leandro931/PIC-Data-Logger/gerber/Rev0a/data_logger_Rev0a.jpg

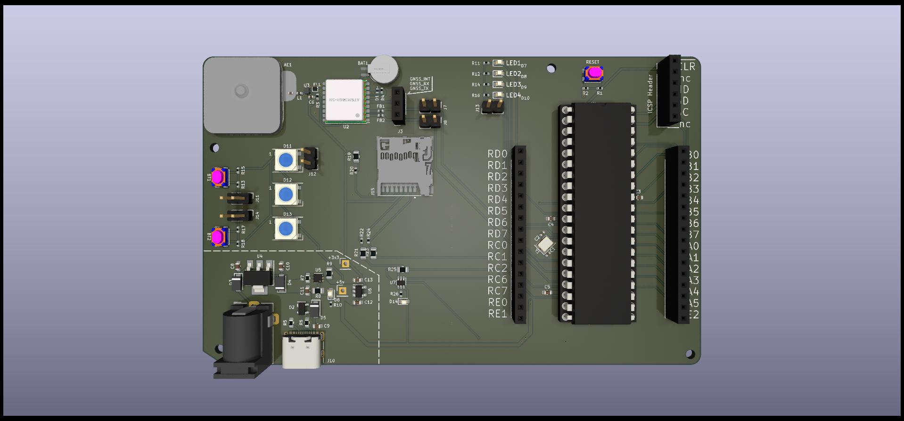
gerber/Rev0a/data_logger_Rev0a.jpg
