leandro931/PIC-Data-Logger/README.md

# PIC-Data-Logger
A data logger based on PIC18F4550 for development
