leandro931/PIC-Data-Logger/gerber/Rev0a/BOM_PIC_data_logger(Rev0a).xlsx

Item | Qty | Reference(s) | To be assembled? | Value | Description | Manufacturer | Manufacturer P/N | Mounting type | Package | digikey# | lcsc# | mouser# | newark# | rs# | tme# | Datasheet
1 | 1 | AE1 | Yes | 2088900001 | GPS Ceramic Patch Antenna | Molex | 2088900001 |  |  | WM26214-ND |  | 538-208890-0001 | 84AC5252 |  |  | https://www.molex.com/content/dam/molex/molex-dot-com/products/automated/en-us/productspecificationpdf/208/208890/2088900001-PS.pdf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 | https://pt.aliexpress.com/item/1005004484929374.html?scm_id=1007.40050.362094.0&scm-url=1007.40050.362094.0
2 | 1 | BAT1 | Yes | MS412FE-FL26E | Coin, 4.8mm 3V Lithium Rechargeable Battery 1mAh (MS412FE is not reflowable. Please mount them on PCB by hand soldering) | Seiko Instruments | MS412FE-FL26E | SMD |  | 728-1053-ND |  | 628-MS412FE-FL26E |  |  |  | https://www.sii.co.jp/en/me/datasheets/ms-rechargeable/ms412fe-5/
3 | 2 | C1, C2 | Yes | 22pF | Multilayer Ceramic Chip Capacitor 22pF | YAGEO | CC0402JRNPO7BN220 | SMD | 0402_1005Metric |  | C2175872 |  |  |  |  | https://datasheet.lcsc.com/lcsc/2202040800_YAGEO-CC0402JRNPO7BN220_C2175872.pdf
4 | 3 | C3, C4, C8 | Yes | 10uF | Multilayer Ceramic Chip Capacitor 10uF | YAGEO | CC0603MRX5R7BB106 | SMD | 0603_1608Metric |  | C109457 |  |  |  |  | https://datasheet.lcsc.com/lcsc/1811021340_YAGEO-CC0603MRX5R7BB106_C109457.pdf
5 | 1 | C5 | Yes | 470nF | Multilayer Ceramic Chip Capacitor 470nF | YAGEO | CC0603KRX7R7BB474 | SMD | 0603_1608Metric |  | C106851
6 | 1 | C6 | Yes | 33nF | Multilayer Ceramic Chip Capacitor 33nF | YAGEO | CC0402FRNPO9BN330 | SMD | 0402_1005Metric |  | C327064
7 | 1 | C7 | Yes | 470pF | Multilayer Ceramic Chip Capacitor 470pF | YAGEO | CC0402JRNPO7BN471 | SMD | 0402_1005Metric |  | C526993
8 | 2 | C9, C10 | Yes | 0.1uF | Multilayer Ceramic Chip Capacitor 0.1uF | YAGEO | CS0603KRX7R8BB104 | SMD | 0603_1608Metric |  | C577419
9 | 1 | C11 | Yes | 100nF | Multilayer Ceramic Chip Capacitor 100nF | YAGEO | CC0603KRX7R9BB104 | SMD | 0603_1608Metric |  | C14663
10 | 2 | C12, C13 | Yes | 22uF | Multilayer Ceramic Chip Capacitor 22uF | YAGEO | CC0603MRX5R5BB226 | SMD | 0603_1608Metric |  | C109448
11 | 1 | D1 | Yes | CDBQC0240LR-HF | Diode 40 V 200mA Surface Mount 0402C/SOD-923F | Comchip Technology | CDBQC0240LR-HF | SMD | 0402/SOD-923F | 641-1888-2-ND | C3758513 |  |  |  |  | https://www.comchiptech.com/admin/files/product/CDBQC0240LR-HF%20RevA836831.pdf
12 | 1 | D2 | Yes | SP0503BAHTG | 8.5V Clamp Ipp Tvs Diode Surface Mount SOT-143-4 | Littelfuse | SP0503BAHTG | SMD | SOT-143 | SP0503BAHT-ND | C7074 |  |  |  |  | http://www.littelfuse.com/~/media/files/littelfuse/technical%20resources/documents/data%20sheets/sp05xxba.pdf
13 | 3 | D3, D4, D5 | Yes | DSK24 | Schottky Barrier Diodes 40V 2A 550mV @ 2A SOD-123FL | MDD (Microdiode Electronics) | DSK24 | SMD | SOD-123FL | 3372-DSK24TR-ND | C64890 |  |  |  |  | https://mm.digikey.com/Volume0/opasdata/d220001/medias/docus/5660/3372_SOD123FK24S204.pdf
14 | 1 | D6 | Yes | LTST-C193KRKT-2A | LED (red) 0603_1608Metric | Lite-On Inc. | LTST-C193KRKT-2A | SMD | 0603_1608 | 160-1909-1-ND |  |  |  |  |  | https://mm.digikey.com/Volume0/opasdata/d220001/medias/docus/525/LTST-C193KRKT-2A.pdf
15 | 4 | D7, D8, D9, D10 | Yes | LTST-C193TBKT-5A | LED (blue) 0603_1608Metric | Lite-On Inc. |  | SMD | 0603_1608 | 160-1827-6-ND | C125103
16 | 3 | D11, D12, D13 | Yes | WS2812B | Intelligent control LED | Wordlsemi | WS2812B | SMD | SMD5050 | 1568-COM-16347TR-ND | C2761795 |  |  |  |  | https://cdn-shop.adafruit.com/datasheets/WS2812B.pdf
17 | 1 | D14 | Yes | LTST-C190YKT | LED (yellow) 0603_1608Metric | Lite-On Inc. | LTST-C190YKT | SMD | 0603_1608 | 160-1184-6-ND | C125097
18 | 2 | FB1, FB2 | Yes | Ferrite_Bead-BLM15HD102SN1D | 1kÎ© @ 100MHz 250mA 1 1.25Î© 0402 Ferrite Beads RoHS | Murata Electronics | BLM15HD102SN1D | SMD | 0402_1005 | 490-4003-2-ND | C21516 | 81-BLM15HD102SN1D |  |  |  | https://datasheet.lcsc.com/szlcsc/1811091923_Murata-Electronics-BLM15HD102SN1D_C21516.pdf
19 | 1 | FL1 | Yes | SAFEA1G58KA0F00R15 | GNSS SAW filter | Murata | SAFEA1G58KA0F00R15 | SMD | QCS5P |  | C91641 |  |  |  |  | https://datasheet.lcsc.com/lcsc/1810161815_Murata-Electronics-SAFEA1G58KA0F00R15_C91641.pdf
20 | 4 | H1, H2, H3, H4 | Not applicable | MountingHole | Mounting hole |  |  |  |  |  |  |  |  |  |  | ~
21 | 2 | J1, J2 | No | PinHeader_01x01_P2.54mm_Vertical | Pin header, single row, 01x01, 1.27mm pitch, vertical |  |  | PTH |  |  |  |  |  |  |  | ~
22 | 1 | J3 | Yes | PinHeader_01x03_P2.54mm | PinHeader_01x03_P2.54mm |  |  | PTH |  |  |  |  |  |  |  | ~
23 | 1 | J4 | Yes | PinHeader_01x06_P2.54mm | PinHeader_01x06_P2.54mm |  |  | PTH |  |  |  |  |  |  |  | ~
24 | 2 | J5, J6 | Yes | PinHeader_01x16_P2.54mm | PinHeader_01x16_P2.54mm |  |  | PTH |  |  |  |  |  |  |  | ~
25 | 6 | J7, J8, J11, J12, J13, J14 | Yes | PinHeader_01x02_P2.54mm | PinHeader_01x02_P2.54mm |  |  | PTH |  |  |  |  |  |  |  | ~
26 | 1 | J9 | Yes | Barrel_Jack_Switch_CUI_PJ-102AH | DC Power Jack with an internal switch | CUI Devices | PJ-102AH | PTH |  | CP-102AH-ND |  | 490-PJ-102AH |  |  |  | https://www.cuidevices.com/product/resource/pj-102ah.pdf
27 | 1 | J10 | Yes | USB_C_Receptacle | USB Type-C Receptacle 16-pin connector | Shenzhen Kinghelm Elec | KH-TYPE-C-16P | SMD |  |  | C709357 |  |  |  |  | https://datasheet.lcsc.com/lcsc/2009111434_Shenzhen-Kinghelm-Elec-KH-TYPE-C-16P_C709357.pdf
28 | 1 | J15 | Yes | 5033981892 | 1.10mm Pitch microSD Memory Card Connector, Normal Mount Surface Mount, PushPush Type, 1.28mm Height | Molex | 503398-1892 | SMD |  | WM11190CT-ND | C428492 |  | 35X2791 | 880-1277 | MX-503398-1892 | https://www.molex.com/pdm_docs/sd/5033981892_sd.pdf
29 | 1 | L1 | Yes | 6.8nH | Inductor 6.8nH | Murata | LQG15HH6N8J02D | SMD | 0402_1005Metric |  | C440214
30 | 3 | R1, R13, R17 | Yes | 470R | Chip Resistor 470R |  |  | SMD | 0402_1005Metric
31 | 3 | R2, R15, R18 | Yes | 10k | Chip Resistor 10k |  |  | SMD | 0402_1005Metric
32 | 1 | R3 | Yes | 4.7k | Chip Resistor 4.7k |  |  | SMD | 0402_1005Metric
33 | 1 | R4 | No | 0R | Chip Resistor 0R |  |  | SMD | 0402_1005Metric
34 | 2 | R5, R6 | Yes | 5.1k | Chip Resistor 5.1k |  |  | SMD | 0603_1608Metric
35 | 1 | R7 | Yes | 332k | Chip Resistor 332k |  |  | SMD | 0603_1608Metric
36 | 1 | R8 | No | 0R | Chip Resistor 0R |  |  | SMD | 0805_2012Metric
37 | 1 | R9 | Yes | 110k | Chip Resistor 110k |  |  | SMD | 0805_2012Metric
38 | 1 | R10 | Yes | 560 | Chip Resistor 560 |  |  | SMD | 0402_1005Metric
39 | 5 | R11, R12, R14, R16, R26 | Yes | 1k | Chip Resistor 1k |  |  | SMD | 0402_1005Metric
40 | 3 | R19, R21, R23 | Yes | 2k2 | Chip Resistor 2k2 |  |  | SMD | 0805_2012Metric |  |  |  |  |  |  | https://www.seielect.com/catalog/sei-rmcf_rmcp.pdf
41 | 3 | R20, R22, R24 | Yes | 3k3 | Chip Resistor 3k3 |  |  | SMD | 0402_1005Metric |  |  |  |  |  |  | https://www.yageo.com/upload/media/product/productsearch/datasheet/rchip/PYu-RC_Group_51_RoHS_L_11.pdf
42 | 1 | R25 | Yes | 10k | Chip Resistor 10k |  |  | SMD | 0805_2012Metric |  |  |  |  |  |  | https://www.seielect.com/catalog/sei-rmcf_rmcp.pdf
43 | 3 | SW1, SW2, SW3 | Yes | SW_Push_Shouhan_TS3315A | Tactile Switch SPST 50mA@12VDC Top Actuated Round Button 5N SMD, 3.3x3.3x1.5mm | Shou Han (Shenzhen Shouhan Technology) | TS3315A | SMD |  |  | C412367 |  |  |  |  | https://datasheet.lcsc.com/lcsc/1912111437_SHOU-HAN-TS3315A_C412367.pdf
44 | 1 | U1 | Yes | PIC18F4550-I/P |  | Microchip | PIC18F4550-I/P | PTH | DIP-40 |  | C648001 |  |  |  |  | http://ww1.microchip.com/downloads/en/DeviceDoc/39760d.pdf
52 |  | U1 | Yes | IC Socket DIP-40 | 40P DIP Square Holes 2.54mm | Cvilux | CS054011A0A | PTH | DIP-40 |  | C918631
45 | 1 | U2 | Yes | ATGM336H-5N32 | Satellite Positioning Module | ZHONGKEWEI | ATGM336H-5N32 | SMD |  |  | C5117921 |  |  |  |  | https://www.icofchina.com/d/file/xiazai/2016-12-05/b5c57074f4b1fcc62ba8c7868548d18a.pdf
46 | 1 | U3 | Yes | AT2659 | Low Noise Amplifiers | ZHONGKEWEI | AT2659 | SMD |  |  | C92450 |  |  |  |  | https://datasheet.lcsc.com/lcsc/1810010517_ZHONGKEWEI-AT2659_C92450.pdf
47 | 1 | U4 | Yes | AMS1117-5.0 | 1A Fixed 5V Positive Linear Voltage Regulators (LDO) | Advanced Monolithic Systems | AMS1117-5.0 | SMD | SOT-223 |  | C6187 |  |  |  |  | https://datasheet.lcsc.com/lcsc/2309181408_Advanced-Monolithic-Systems-AMS1117-5-0_C6187.pdf
48 | 1 | U5 | Yes | TPS25200 | 2.5-V to 6.5-V, 60mÎ©, 0.085-2.9A eFuse with reverse current blocking, 6-WSON | Texas Instruments | TPS25200DRVR | SMD | 6-WSON | 296-37842-1-ND | C128401 | 595-TPS25200DRVR |  |  |  | https://www.ti.com/lit/ds/symlink/tps25200.pdf
49 | 1 | U6 | Yes | XC6210B332MR | Fixed 6.5V 3.3V 900mA SOT-25 Low Dropout Regulator (LDO) | Torex | XC6210B332MR | SMD | SOT-25 | 893-1075-1-ND | C47719 | 865-XC6210B332MR-G | 93K1442 |  | XC6210B332MR | https://www.torexsemi.com/file/xc6210/XC6210.pdf
50 | 1 | U7 | Yes | TMP126 | SPI Temperature Sensor | Texas | TMP126 | SMD | SC-70-6 |  | C5219871 |  |  |  |  | https://www.ti.com/lit/gpn/tmp126
51 | 1 | Y1 | Yes | X1E0000210624 | 20MHz 12pF Â±10ppm SMD3225-4P Crystals ROHS | Seiko Epson | Q24FA20H00431 | SMD |  |  | C255914 | 732-FA20H2712MA3XC |  |  |  | https://support.epson.biz/td/api/doc_check.php?mode=dl&lang=en&Parts=X1E0000210624
