leandro931/PIC-Data-Logger/data_logger.kicad_pcb

## KiCad design data_logger.kicad_pcb (2024-11-20)

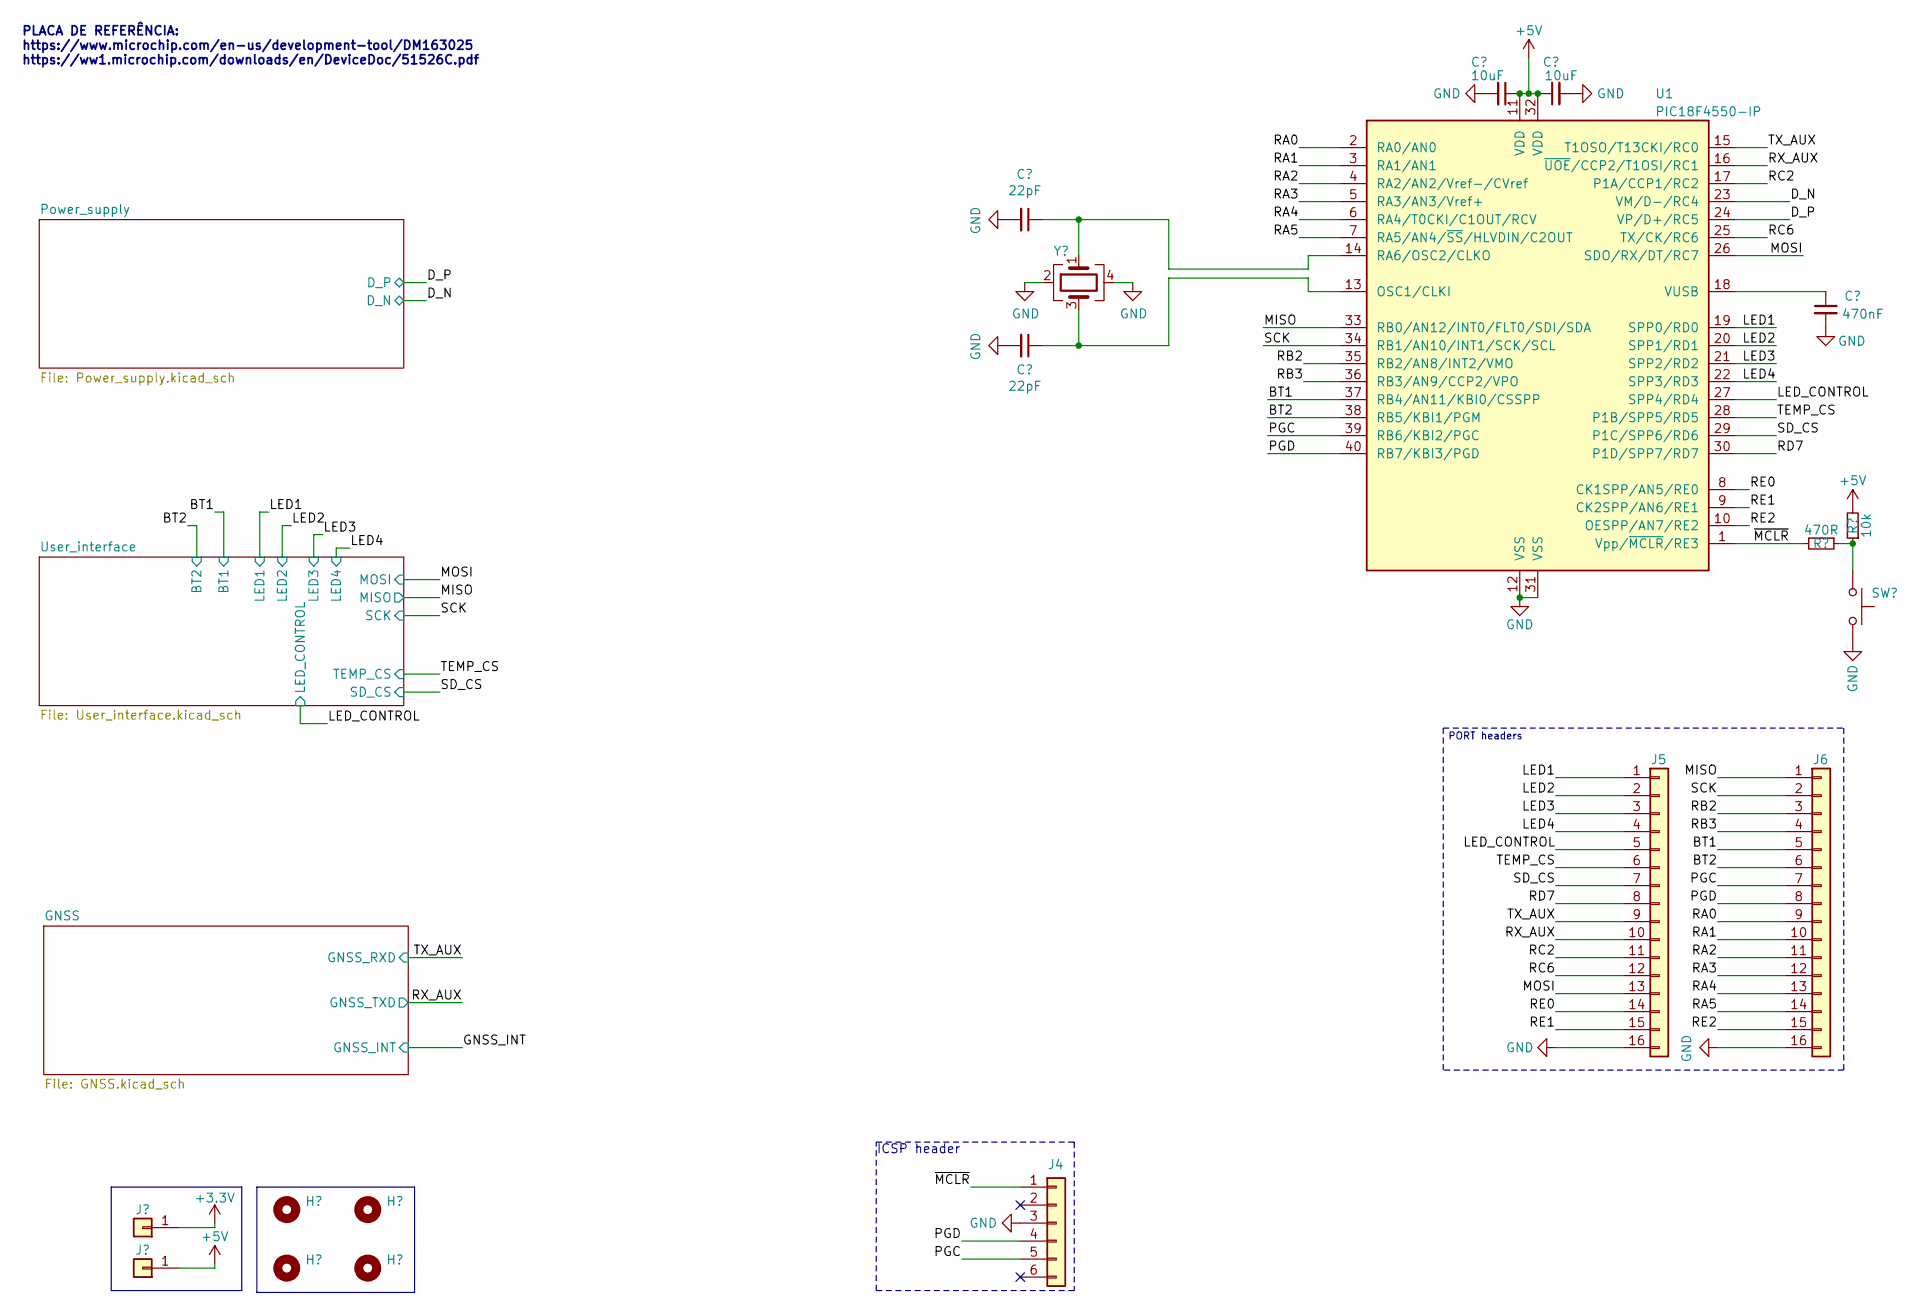
[picture p2: schematic data_logger.kicad_sch, Data Logger + PIC18F4550]

Parts:
C1, C2: 22pF; C_0402_1005Metric; Voltage rating greater than or equal to 50V; Tolerance less than or equal to ±1%
C3, C4: 10uF; C_0603_1608Metric; Tolerance less than or equal to ±10%; Voltage rating greater than or equal to 50V
C5: 470nF; C_0603_1608Metric; Tolerance less than or equal to ±10%; Voltage rating greater than or equal to 50V
H1, H2, H3, H4: MountingHole; MountingHole_2.2mm_M2
J1, J2: PinHeader_01x01_P2.54mm_Vertical; PinHeader_1x01_P2.54mm_Vertical
J4: PinHeader_01x06_P2.54mm_Vertical; PinHeader_1x06_P2.54mm_Vertical
J5, J6: Conn_01x16; PinSocket_1x16_P2.54mm_Vertical
R1: 470R; R_0402_1005Metric; Power rating greater than or equal to 1/10W; Tolerance less than or equal to ±5%
R2: 10k; R_0402_1005Metric; Power rating greater than or equal to 1/10W; Tolerance less than or equal to ±5%
SW1: SW_Push_Shouhan_TS3315A; SW_Push_SPST_TopActuated_Shouhan_TS3315A; Power rating 50mA@12VDC; Manufacturer P/N TS3315A; lcsc# C412367
U1: PIC18F4550-IP; DIP-40_W15.24mm
Y1: X1E0000210624; Crystal_SMD_3225-4Pin_3.2x2.5mm; Manufacturer P/N Q24FA20H00431; lcsc# C255914

Connections:
+3.3V: J1.1; also elsewhere on the board
+5V: C3.1, C4.1, J2.1, R2.2, U1.11 (VDD), U1.32 (VDD); also elsewhere on the board
/BT1: J6.5, U1.37 (RB4/AN11/KBI0/CSSPP); also elsewhere on the board
/BT2: J6.6, U1.38 (RB5/KBI1/PGM); also elsewhere on the board
/D_N: U1.23 (VM/D-/RC4); also elsewhere on the board
/D_P: U1.24 (VP/D+/RC5); also elsewhere on the board
/LED1: J5.1, U1.19 (SPP0/RD0); also elsewhere on the board
/LED2: J5.2, U1.20 (SPP1/RD1); also elsewhere on the board
/LED3: J5.3, U1.21 (SPP2/RD2); also elsewhere on the board
/LED4: J5.4, U1.22 (SPP3/RD3); also elsewhere on the board
/LED_CONTROL: J5.5, U1.27 (SPP4/RD4); also elsewhere on the board
/MISO: J6.1, U1.33 (RB0/AN12/INT0/FLT0/SDI/SDA); also elsewhere on the board
/MOSI: J5.13, U1.26 (SDO/RX/DT/RC7); also elsewhere on the board
/PGC: J4.5, J6.7, U1.39 (RB6/KBI2/PGC)
/PGD: J4.4, J6.8, U1.40 (RB7/KBI3/PGD)
/RA0: J6.9, U1.2 (RA0/AN0)
/RA1: J6.10, U1.3 (RA1/AN1)
/RA2: J6.11, U1.4 (RA2/AN2/Vref-/CVref)
/RA3: J6.12, U1.5 (RA3/AN3/Vref+)
/RA4: J6.13, U1.6 (RA4/T0CKI/C1OUT/RCV)
/RA5: J6.14, U1.7 (RA5/AN4/~SS/HLVDIN/C2OUT)
/RB2: J6.3, U1.35 (RB2/AN8/INT2/VMO)
/RB3: J6.4, U1.36 (RB3/AN9/CCP2/VPO)
/RC2: J5.11, U1.17 (P1A/CCP1/RC2)
/RC6: J5.12, U1.25 (TX/CK/RC6)
/RD7: J5.8, U1.30 (P1D/SPP7/RD7)
/RE0: J5.14, U1.8 (CK1SPP/AN5/RE0)
/RE1: J5.15, U1.9 (CK2SPP/AN6/RE1)
/RE2: J6.15, U1.10 (OESPP/AN7/RE2)
/RX_AUX: J5.10, U1.16 (~UOE/CCP2/T1OSI/RC1); also elsewhere on the board
/SCK: J6.2, U1.34 (RB1/AN10/INT1/SCK/SCL); also elsewhere on the board
/SD_CS: J5.7, U1.29 (P1C/SPP6/RD6); also elsewhere on the board
/TEMP_CS: J5.6, U1.28 (P1B/SPP5/RD5); also elsewhere on the board
/TX_AUX: J5.9, U1.15 (T1OSO/T13CKI/RC0); also elsewhere on the board
/~MCLR: J4.1, R1.2, U1.1 (Vpp/~MCLR/RE3)
GND: C1.2, C2.2, C3.2, C4.2, C5.2, J4.3, J5.16, J6.16, SW1.2, U1.12 (VSS), U1.31 (VSS), Y1.2, Y1.4; also elsewhere on the board
unnamed: R1.1, R2.1, SW1.1
unnamed: C2.1, U1.13 (OSC1/CLKI), Y1.3
unnamed: C1.1, U1.14 (RA6/OSC2/CLKO), Y1.1
unnamed: C5.1, U1.18 (VUSB)

Notes on the sheet:
ICSP header
PLACA DE REFERÊNCIA: https://www.microchip.com/en-us/development-tool/DM163025 https://ww1.microchip.com/downloads/en/DeviceDoc/51526C.pdf
PORT headers

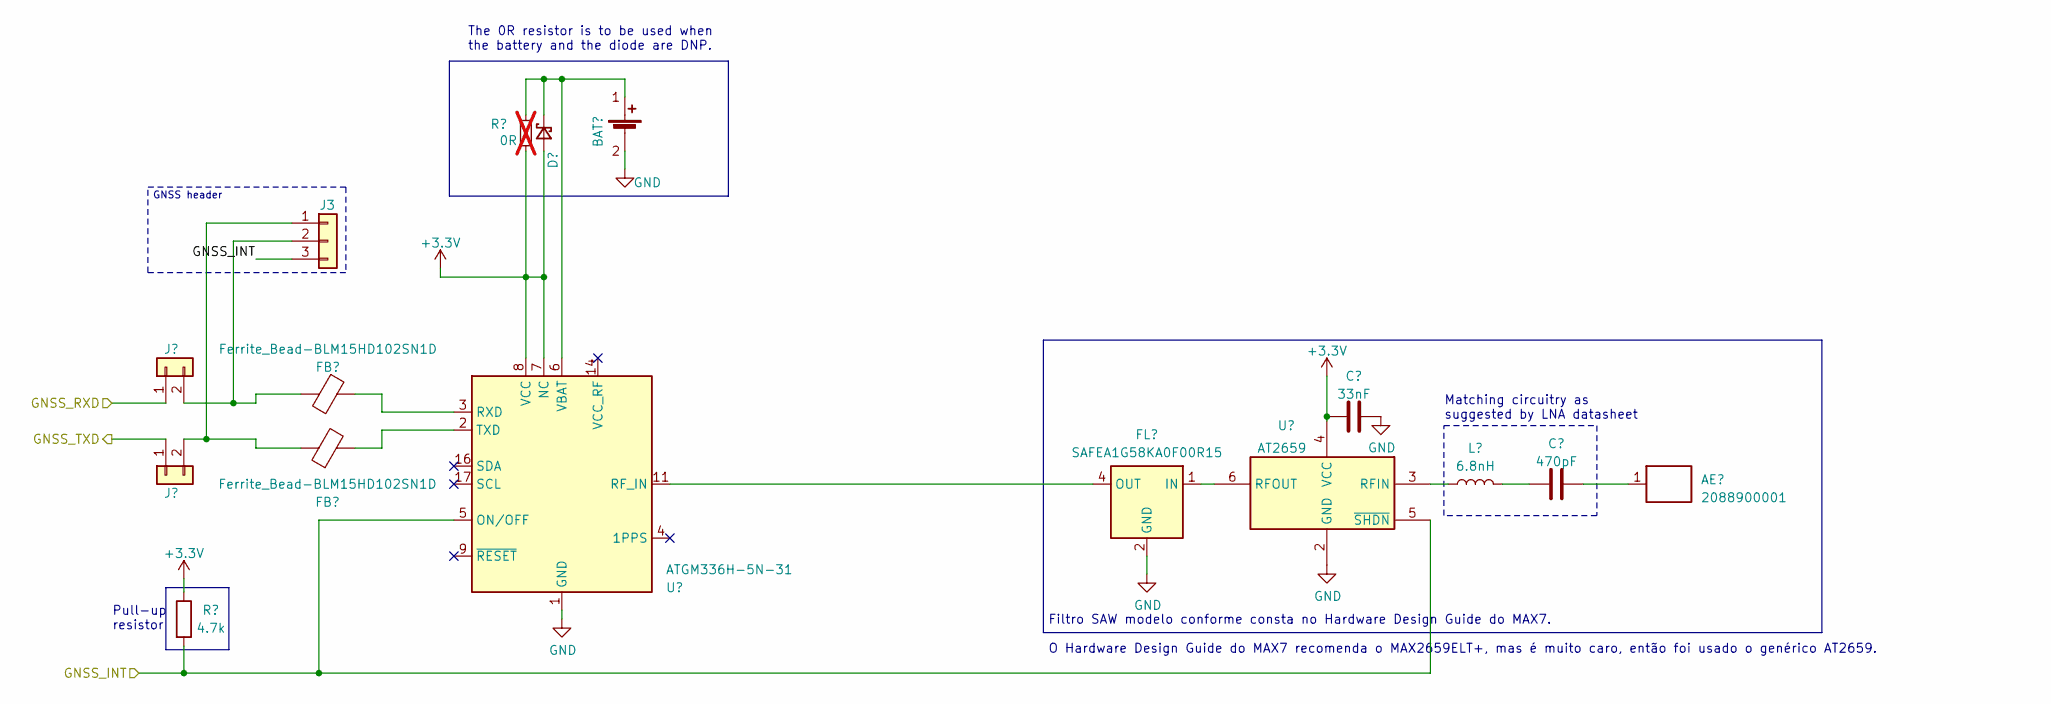
[picture p3: schematic GNSS.kicad_sch, Data Logger + PIC18F4550]

Parts:
AE1: 2088900001; Molex-2088900001-GPS-Ceramic_Antenna; Power rating 2W max. (CW); Manufacturer P/N 2088900001; mouser# 538-208890-0001
BAT1: Battery_Seiko_MS412FE_D4.8mm; Manufacturer P/N MS412FE-FL26E; digikey# 728-1053-ND
C6: 33nF; C_0402_1005Metric; Tolerance less than or equal to ±10%; Voltage rating greater than or equal to 16V
C7: 470pF; C_0402_1005Metric; Tolerance less than or equal to ±10%; Voltage rating greater than or equal to 16V
D1: CDBQC0240LR-HF; D_0402_1006Metric; Manufacturer P/N CDBQC0240LR-HF; digikey# 641-1888-1-ND
FB1, FB2: Ferrite_Bead-BLM15HD102SN1D; L_0402_1005Metric; Manufacturer P/N BLM15HD102SN1D
FL1: SAFEA1G58KA0F00R15; Filter_1109-5_1.1x0.9mm; Manufacturer P/N SAFEA1G58KA0F00R15; lcsc# C91641
J3: Conn_01x03; PinSocket_1x03_P2.54mm_Vertical
J7, J8: PinHeader_01x02_P2.54mm_Vertical; PinHeader_1x02_P2.54mm_Vertical
L1: 6.8nH; L_0402_1005Metric
R3: 4.7k; R_0402_1005Metric; Power rating 1/8W; Tolerance ±1%; Manufacturer P/N RS-05K4701FT; LCSC P/N C115319
R4: 0R; R_0402_1005Metric; Power rating greater than or equal to 1/16W; Tolerance Jumper; Manufacturer P/N CRCW04020000Z0ED; digikey# 541-0.0JCT-ND; not fitted
U2: ATGM336H-5N-31; atgm336h; Manufacturer P/N ATGM336H-5N31
U3: AT2659; lcsc# C92450

Connections:
+3.3V: C6.1, D1.2 (A), R3.1, R4.2, U2.7 (NC), U2.8 (VCC), U3.4 (VCC); also elsewhere on the board
/GNSS_INT: J3.3, R3.2, U2.5 (ON/OFF), U3.5 (~SHDN)
/RX_AUX: J8.1; also elsewhere on the board
/TX_AUX: J7.1; also elsewhere on the board
GND: BAT1.2 (-), C6.2, FL1.2 (GND), FL1.3 (GND), FL1.5 (GND), U2.1 (GND), U2.10 (GND), U2.12 (GND), U3.1 (GND), U3.2 (GND); also elsewhere on the board
unnamed: AE1.1, C7.2
unnamed: BAT1.1 (+), D1.1 (K), R4.1, U2.6 (VBAT)
unnamed: C7.1, L1.2
unnamed: FL1.1 (IN), U3.6 (RFOUT)
unnamed: FL1.4 (OUT), U2.11 (RF_IN)
unnamed: FB2.1, J3.1, J8.2
unnamed: FB1.2, J3.2, J7.2
unnamed: FB1.1, U2.3 (RXD)
unnamed: FB2.2, U2.2 (TXD)
unnamed: L1.1, U3.3 (RFIN)

Notes on the sheet:
Filtro SAW modelo conforme consta no Hardware Design Guide do MAX7. O Hardware Design Guide do MAX7 recomenda o MAX2659ELT+, mas é muito caro, então foi usado o genérico AT2659.
The 0R resistor is to be used when the battery and the diode are DNP.
Matching circuitry as suggested by LNA datasheet
Pull-up resistor
GNSS header

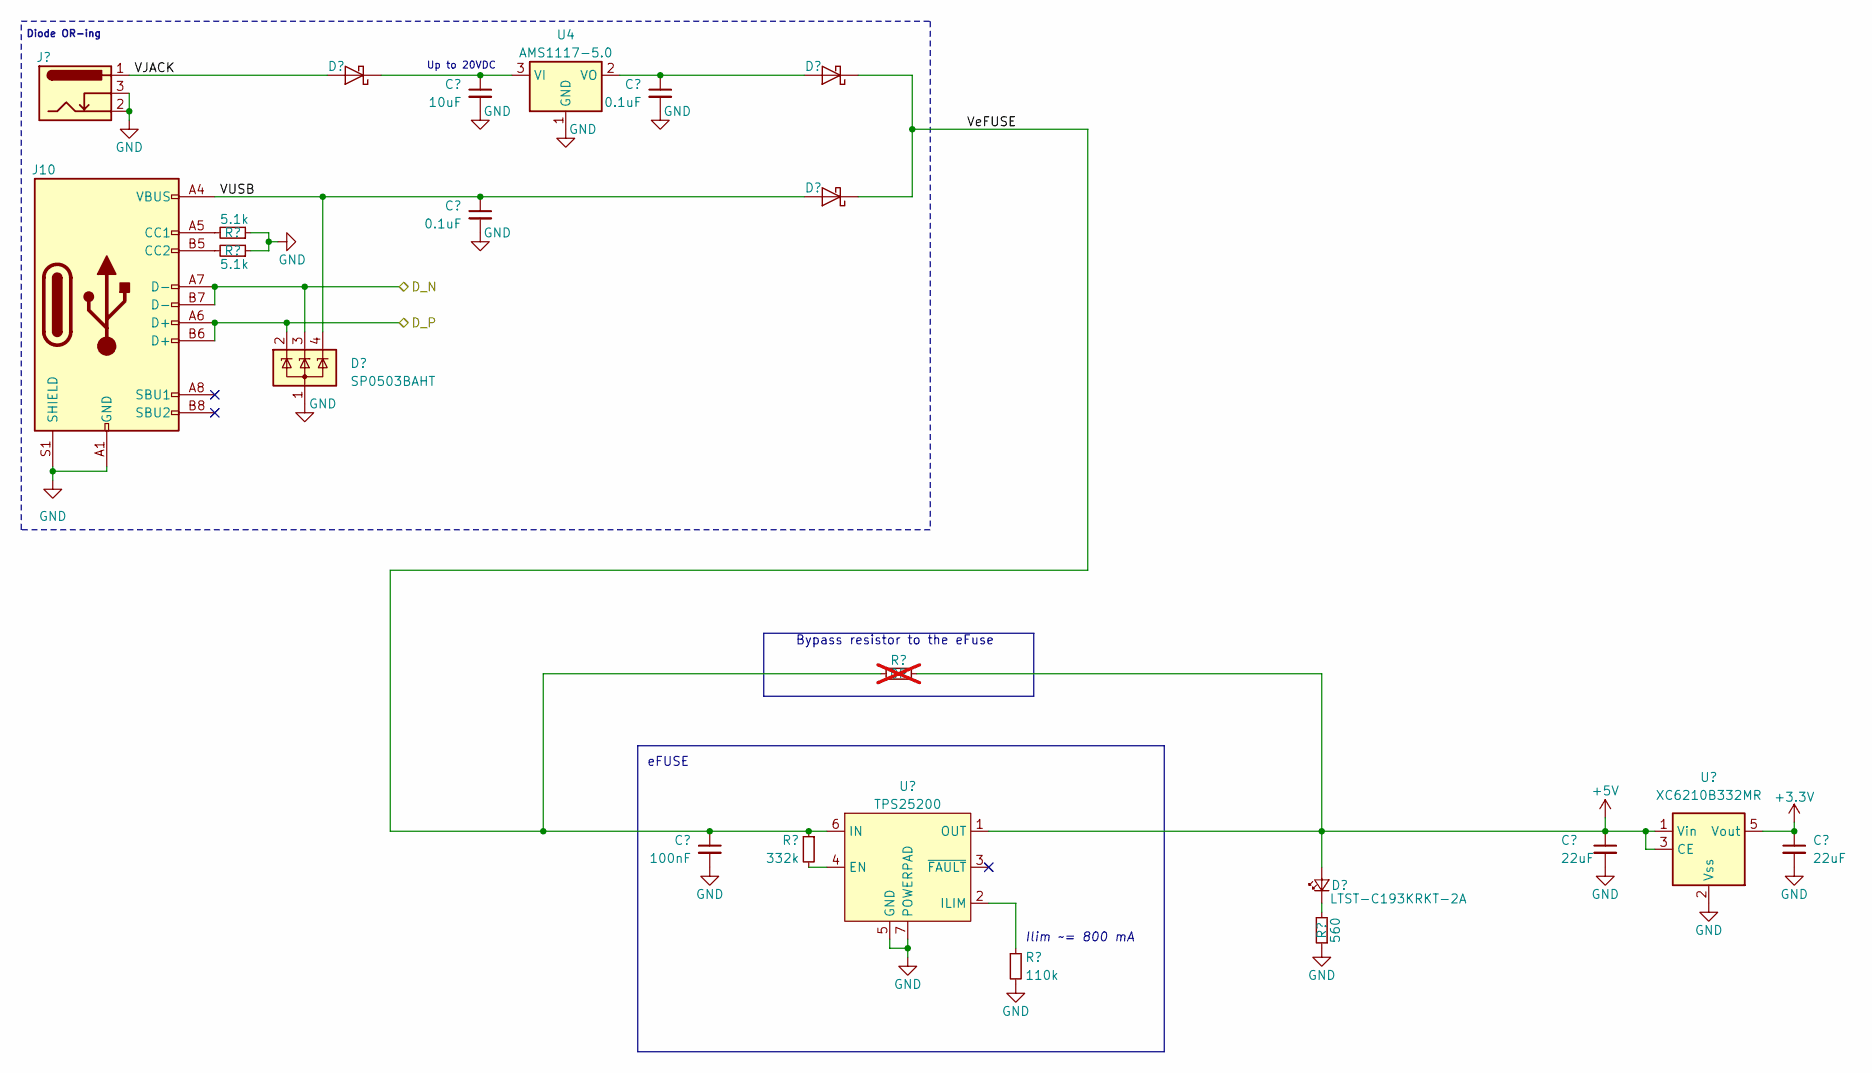
[picture p4: schematic Power_supply.kicad_sch, Data Logger + PIC18F4550]

Parts:
C8: 10uF; C_0603_1608Metric; Tolerance less than or equal to ±10%; Voltage rating greater than or equal to 50V
C9, C10: 0.1uF; C_0603_1608Metric; Tolerance less than or equal to ±10%; Voltage rating greater than or equal to 50V
C11: 100nF; C_0603_1608Metric; Tolerance less than or equal to ±10%; Voltage rating greater than or equal to 50V; Manufacturer P/N 08055C104KAT2A; digikey# 478-1395-1-ND
C12, C13: 22uF; C_0603_1608Metric; Tolerance less than or equal to ±20%; Voltage rating greater than or equal to 16V; Manufacturer P/N 1206YD226MAT2A; digikey# 478-5332-1-ND
D2: SP0503BAHT; SOT-143
D3, D4, D5: DSK24_K24; Microdiode_SOD-123FL; Manufacturer P/N DSK24 K24; lcsc# C64890
D6: LTST-C193KRKT-2A; LED_0603_1608Metric; Manufacturer P/N LTST-C193KRKT-2A; digikey# 160-1909-1-ND
J9: Barrel_Jack_Switch_CUI_PJ-102AH; BarrelJack_CUI_PJ-102AH_Horizontal; Manufacturer P/N PJ-102AH; digikey# CP-102AH-ND
J10: USB_C_Receptacle; USB_C_Receptacle_GCT_USB4105-xx-A_16P_TopMnt_Horizontal; Manufacturer P/N KH-TYPE-C-16P; lcsc# C709357
R5, R6: 5.1k; R_0603_1608Metric; Power rating greater than or equal to 1/10W; Tolerance less than or equal to ±1%; Manufacturer P/N CRCW0603332KFKEA; digikey# 541-332KHCT-ND
R7: 332k; R_0603_1608Metric; Power rating greater than or equal to 1/10W; Tolerance less than or equal to ±1%; Manufacturer P/N CRCW0603332KFKEA; digikey# 541-332KHCT-ND
R8: 0R; R_0805_2012Metric; Power rating greater than or equal to 1/8W; Tolerance Jumper; Manufacturer P/N RMCF0805ZT0R00; digikey# RMCF0805ZT0R00CT-ND; not fitted
R9: 110k; R_0805_2012Metric; Power rating greater than or equal to 1/8W; Tolerance less than or equal to ±0,1%; Manufacturer P/N RT0805BRD07169KL; digikey# YAG4836CT-ND
R10: 560; R_0402_1005Metric; Power rating greater than or equal to 1/10W; Tolerance less than or equal to ±5%; Manufacturer P/N RC0603JR-072KL; digikey# 311-2.0KGRCT-ND
U4: AMS1117-5.0; SOT-223-3_TabPin2
U5: TPS25200; Texas_DRV0006A_WSON-6-1EP_2x2mm_P0.65mm_EP1x1.6mm_ThermalVi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; Manufacturer P/N TPS25200DRVR; digikey# 296-37842-1-ND
U6: XC6210B332MR; Torex_SOT-25; Manufacturer P/N XC6210B332MR; digikey# 893-1075-1-ND

Connections:
+3.3V: C13.1, U6.5 (Vout); also elsewhere on the board
+5V: C12.1, D6.2 (A), R8.2, U5.1 (OUT), U6.1 (Vin), U6.3 (CE); also elsewhere on the board
/D_N: D2.3 (K), J10.A7 (D-), J10.B7 (D-); also elsewhere on the board
/D_P: D2.2 (K), J10.A6 (D+), J10.B6 (D+); also elsewhere on the board
/Power_supply/VJACK: D3.2 (A), J9.1
/Power_supply/VUSB: C9.1, D2.4 (K), D5.2 (A), J10.A4 (VBUS), J10.A9 (VBUS), J10.B4 (VBUS), J10.B9 (VBUS)
/Power_supply/VeFUSE: C11.1, D4.1 (K), D5.1 (K), R7.1, R8.1, U5.6 (IN)
GND: C8.2, C9.2, C10.2, C11.2, C12.2, C13.2, D2.1 (A), J9.2, J9.3, J10.A1 (GND), J10.A12 (GND), J10.B1 (GND), J10.B12 (GND), J10.S1 (SHIELD), R5.1, R6.1, R9.2, R10.1, U4.1 (GND), U5.5 (GND), U5.7 (POWERPAD), U6.2 (Vss); also elsewhere on the board
unnamed: C8.1, D3.1 (K), U4.3 (VI)
unnamed: C10.1, D4.2 (A), U4.2 (VO)
unnamed: D6.1 (K), R10.2
unnamed: J10.A5 (CC1), R5.2
unnamed: J10.B5 (CC2), R6.2
unnamed: R7.2, U5.4 (EN)
unnamed: R9.1, U5.2 (ILIM)

Notes on the sheet:
eFUSE
Ilim ~= 800 mA
Up to 20VDC
Diode OR-ing
Bypass resistor to the eFuse

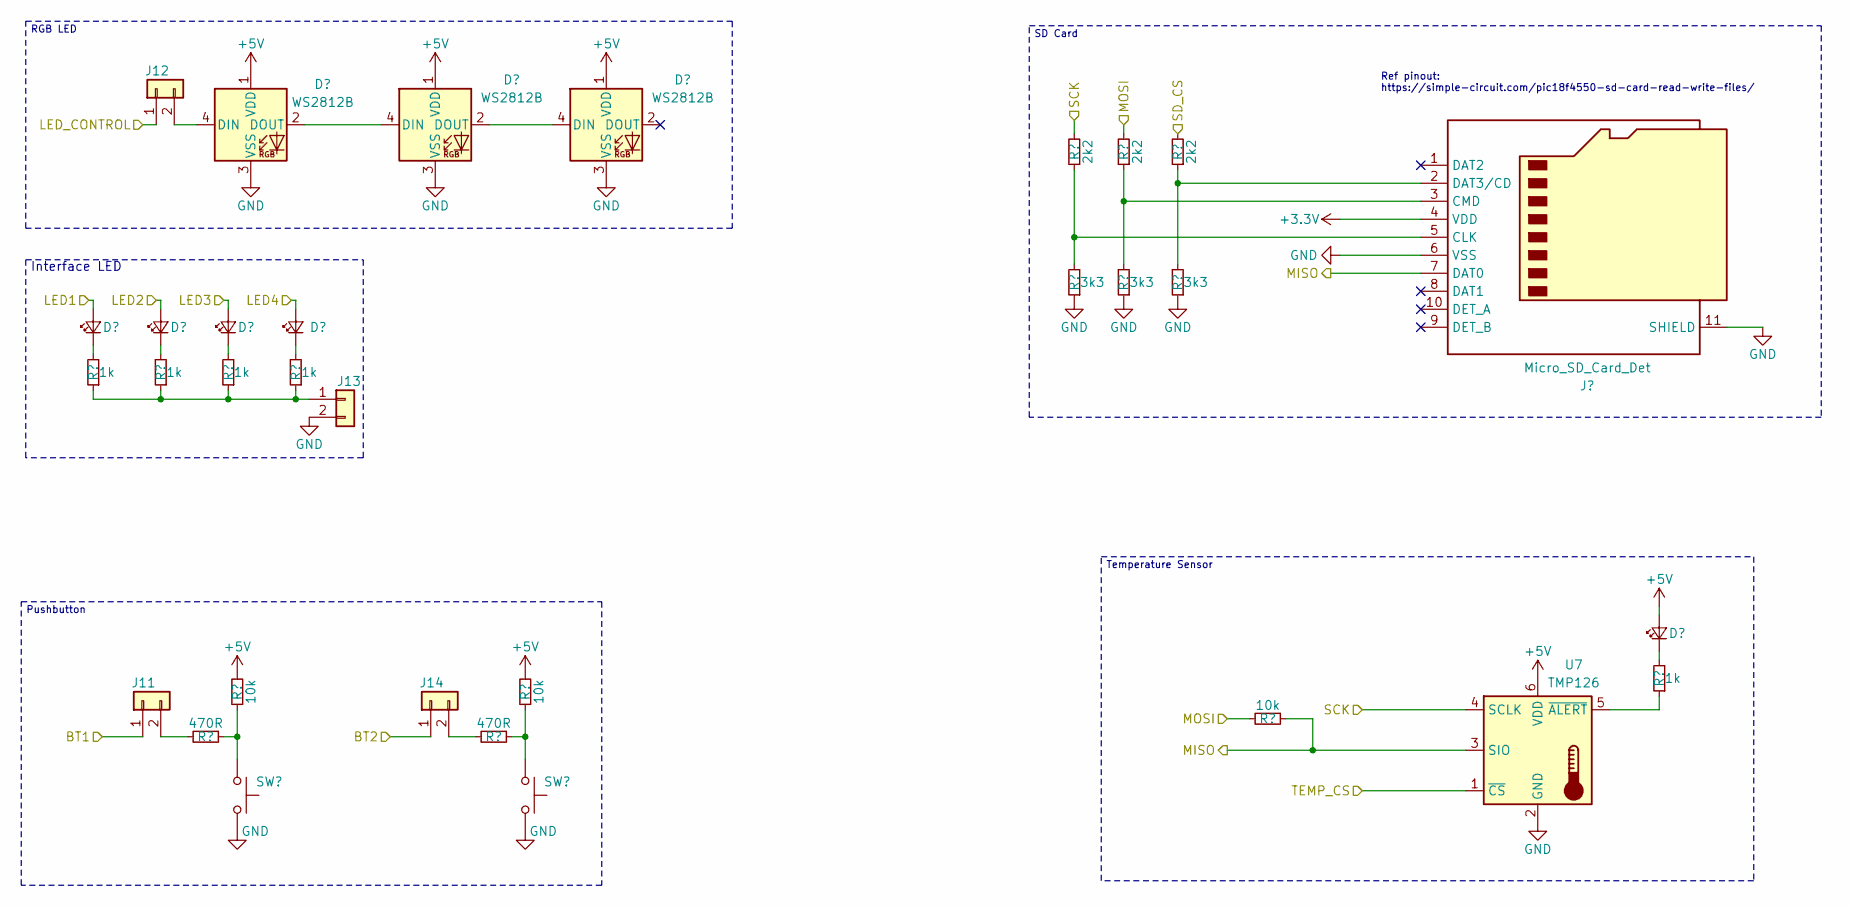
[picture p5: schematic User_interface.kicad_sch, Data Logger + PIC18F4550]

Parts:
D7, D8, D9, D10, D14: LTST-C193KRKT-2A; LED_0603_1608Metric; Manufacturer P/N LTST-C193KRKT-2A; digikey# 160-1909-1-ND
D11, D12, D13: WS2812B; LED_WS2812B_PLCC4_5.0x5.0mm_P3.2mm; Manufacturer P/N WS2812B
J11, J12, J13, J14: PinHeader_01x02_P2.54mm_Vertical; PinHeader_1x02_P2.54mm_Vertical
J15: Micro_SD_Card_Det; SDCARD_MOLEX_503398-1892; Manufacturer P/N 503398-1892; digikey# WM11190CT-ND
R11, R12, R14, R16, R26: 1k; R_0402_1005Metric; Power rating greater than or equal to 1/10W; Tolerance less than or equal to ±5%
R13, R17: 470R; R_0402_1005Metric; Power rating greater than or equal to 1/10W; Tolerance less than or equal to ±5%
R15, R18: 10k; R_0402_1005Metric; Power rating greater than or equal to 1/10W; Tolerance less than or equal to ±5%
R19, R21, R23: 2k2; R_0805_2012Metric; Power rating greater than or equal to 1/8W; Tolerance Jumper
R20, R22, R24: 3k3; R_0402_1005Metric; Power rating greater than or equal to 1/10W; Tolerance less than or equal to ±5%
R25: 10k; R_0805_2012Metric; Power rating greater than or equal to 1/8W; Tolerance Jumper
SW2, SW3: SW_Push_Shouhan_TS3315A; SW_Push_SPST_TopActuated_Shouhan_TS3315A; Power rating 50mA@12VDC; Manufacturer P/N TS3315A; lcsc# C412367
U7: TMP126; pSemi_SC-70-6; Manufacturer # TMP126

Connections:
+3.3V: J15.4 (VDD); also elsewhere on the board
+5V: D11.1 (VDD), D12.1 (VDD), D13.1 (VDD), D14.2 (A), R15.2, R18.2, U7.6 (VDD); also elsewhere on the board
/BT1: J11.1; also elsewhere on the board
/BT2: J14.1; also elsewhere on the board
/LED1: D7.2 (A); also elsewhere on the board
/LED2: D8.2 (A); also elsewhere on the board
/LED3: D9.2 (A); also elsewhere on the board
/LED4: D10.2 (A); also elsewhere on the board
/LED_CONTROL: J12.1; also elsewhere on the board
/MISO: J15.7 (DAT0), R25.1, U7.3 (SIO); also elsewhere on the board
/MOSI: R21.2, R25.2; also elsewhere on the board
/SCK: R19.2, U7.4 (SCLK); also elsewhere on the board
/SD_CS: R23.2; also elsewhere on the board
/TEMP_CS: U7.1 (~CS); also elsewhere on the board
GND: D11.3 (VSS), D12.3 (VSS), D13.3 (VSS), J13.2, J15.6 (VSS), J15.11 (SHIELD), R20.1, R22.1, R24.1, SW2.2, SW3.2, U7.2 (GND); also elsewhere on the board
unnamed: D7.1 (K), R11.2
unnamed: D8.1 (K), R12.2
unnamed: D9.1 (K), R14.2
unnamed: D10.1 (K), R16.2
unnamed: D11.4 (DIN), J12.2
unnamed: D11.2 (DOUT), D12.4 (DIN)
unnamed: D12.2 (DOUT), D13.4 (DIN)
unnamed: D14.1 (K), R26.2
unnamed: J11.2, R13.2
unnamed: J13.1, R11.1, R12.1, R14.1, R16.1
unnamed: J14.2, R17.2
unnamed: J15.5 (CLK), R19.1, R20.2
unnamed: J15.3 (CMD), R21.1, R22.2
unnamed: J15.2 (DAT3/CD), R23.1, R24.2
unnamed: R13.1, R15.1, SW2.1
unnamed: R17.1, R18.1, SW3.1
unnamed: R26.1, U7.5 (~ALERT)

Notes on the sheet:
Pushbutton
Ref pinout: https://simple-circuit.com/pic18f4550-sd-card-read-write-files/
Interface LED
Temperature Sensor
SD Card
RGB LED

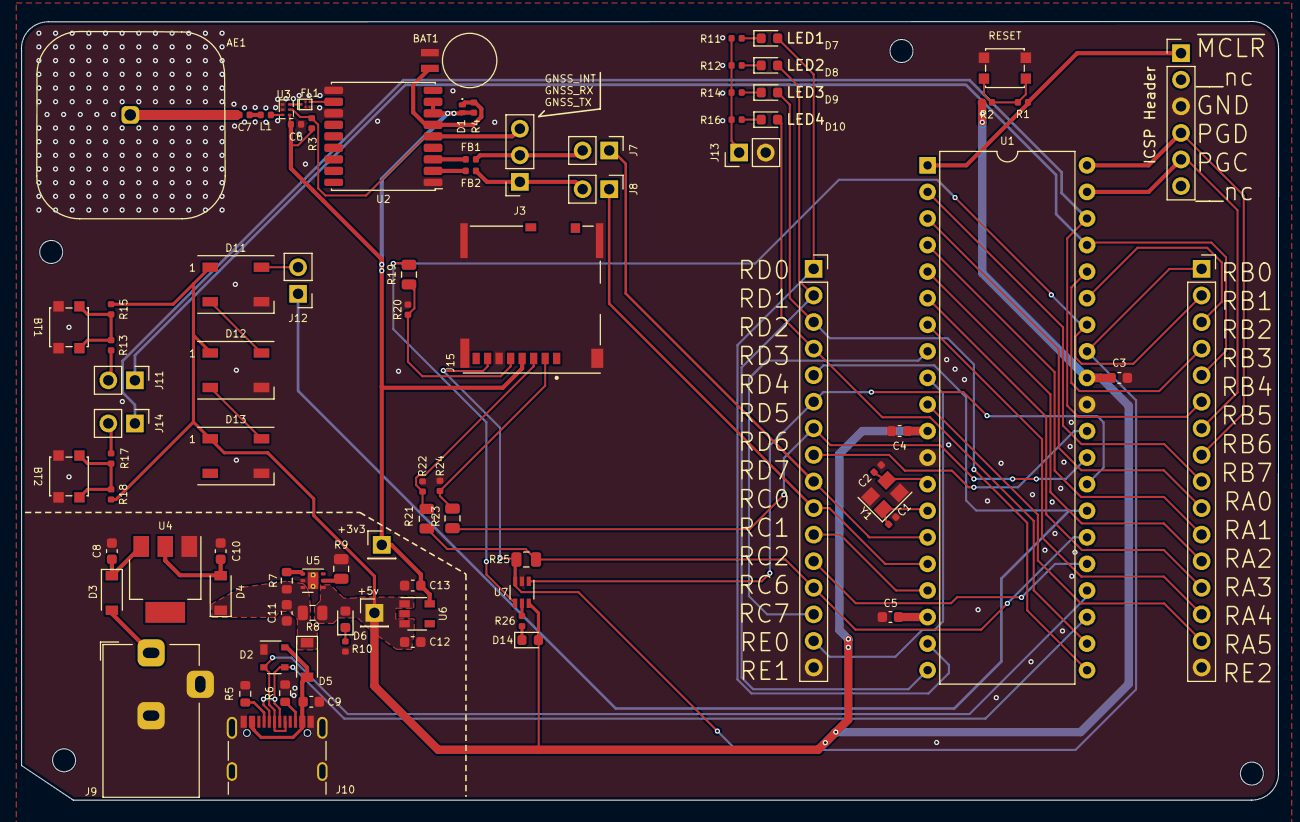
[picture p6: board data_logger.kicad_pcb from above]

Board: 2 copper layers, 120.2 x 74.4 mm, 89 parts (0 on the bottom side), 78 nets.
