leandro931/PIC-Data-Logger/(commit log)

2023-11-16 Teste de commit pelo VS Code
2023-11-20 Inclusão dos arquivos de fabricação para 1ª cotação
    [BOM_PIC_data_logger(Rev0a).xlsx, Power_supply.kicad_sch, User_interface.kicad_sch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]
2024-11-20 Menores ajustes
    [data_logger.kicad_pcb]
